Lotura-STAC/STAC-Embedded/README.md

# STAC-Embedded
Hardware PCB & Image
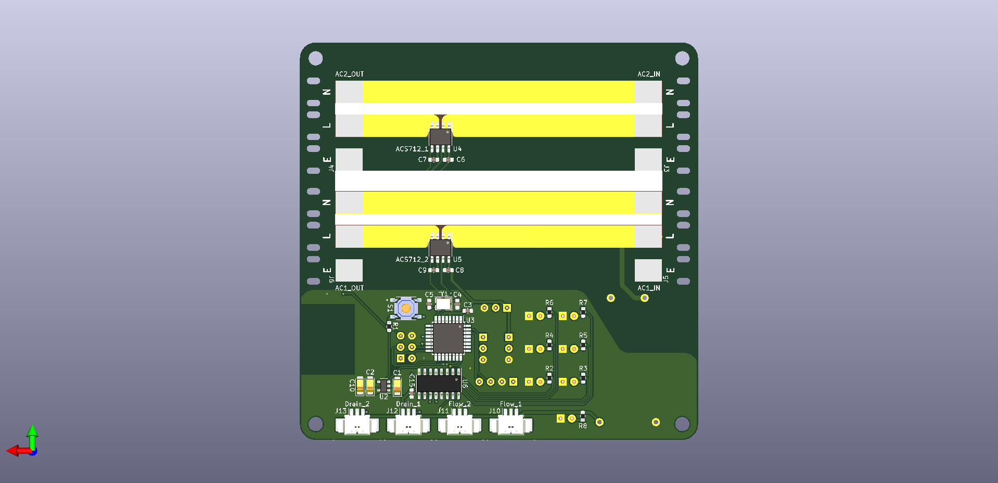
[picture p1: HardWare/Image/ac_current_v1_botom.png]
bottom

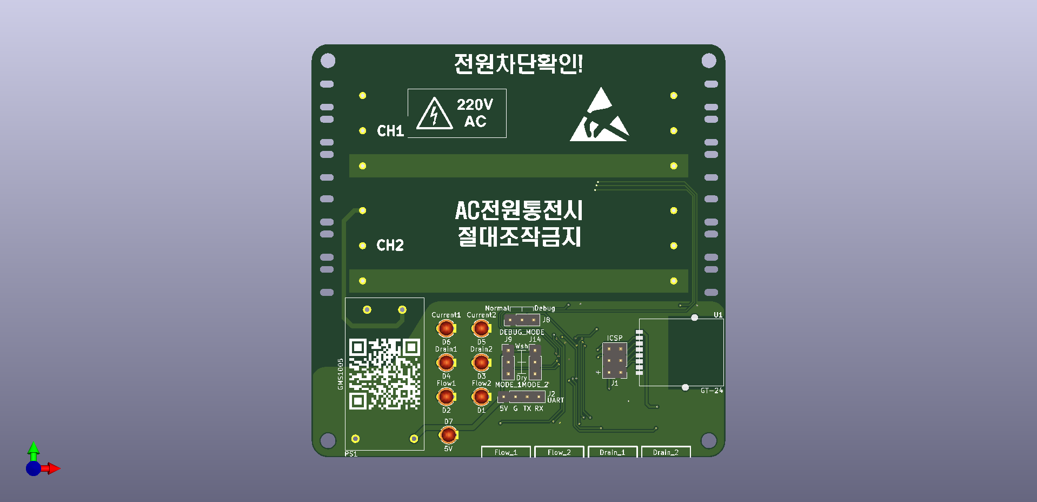
[picture p2: HardWare/Image/ac_current_v1_top.png]
top
