Lotura-STAC/STAC-Embedded/HardWare/Image/KakaoTalk_20230524_181618961.jpg

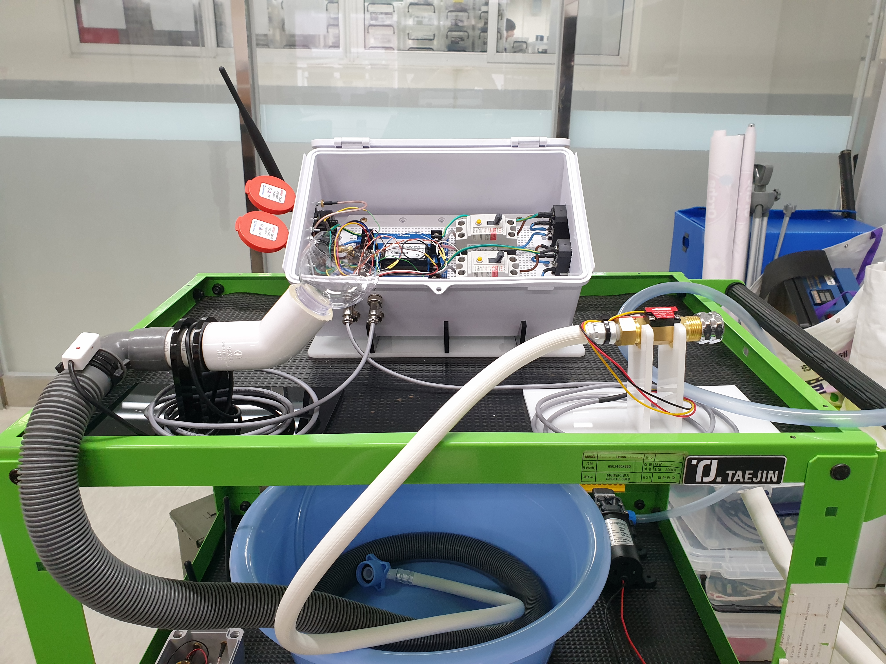
HardWare/Image/KakaoTalk_20230524_181618961.jpg
