Lotura-STAC/STAC-Embedded/HardWare/PCB/ac_current_v1.kicad_pcb

## KiCad design HardWare/PCB/ac_current_v1.kicad_pcb (2023-09-21)

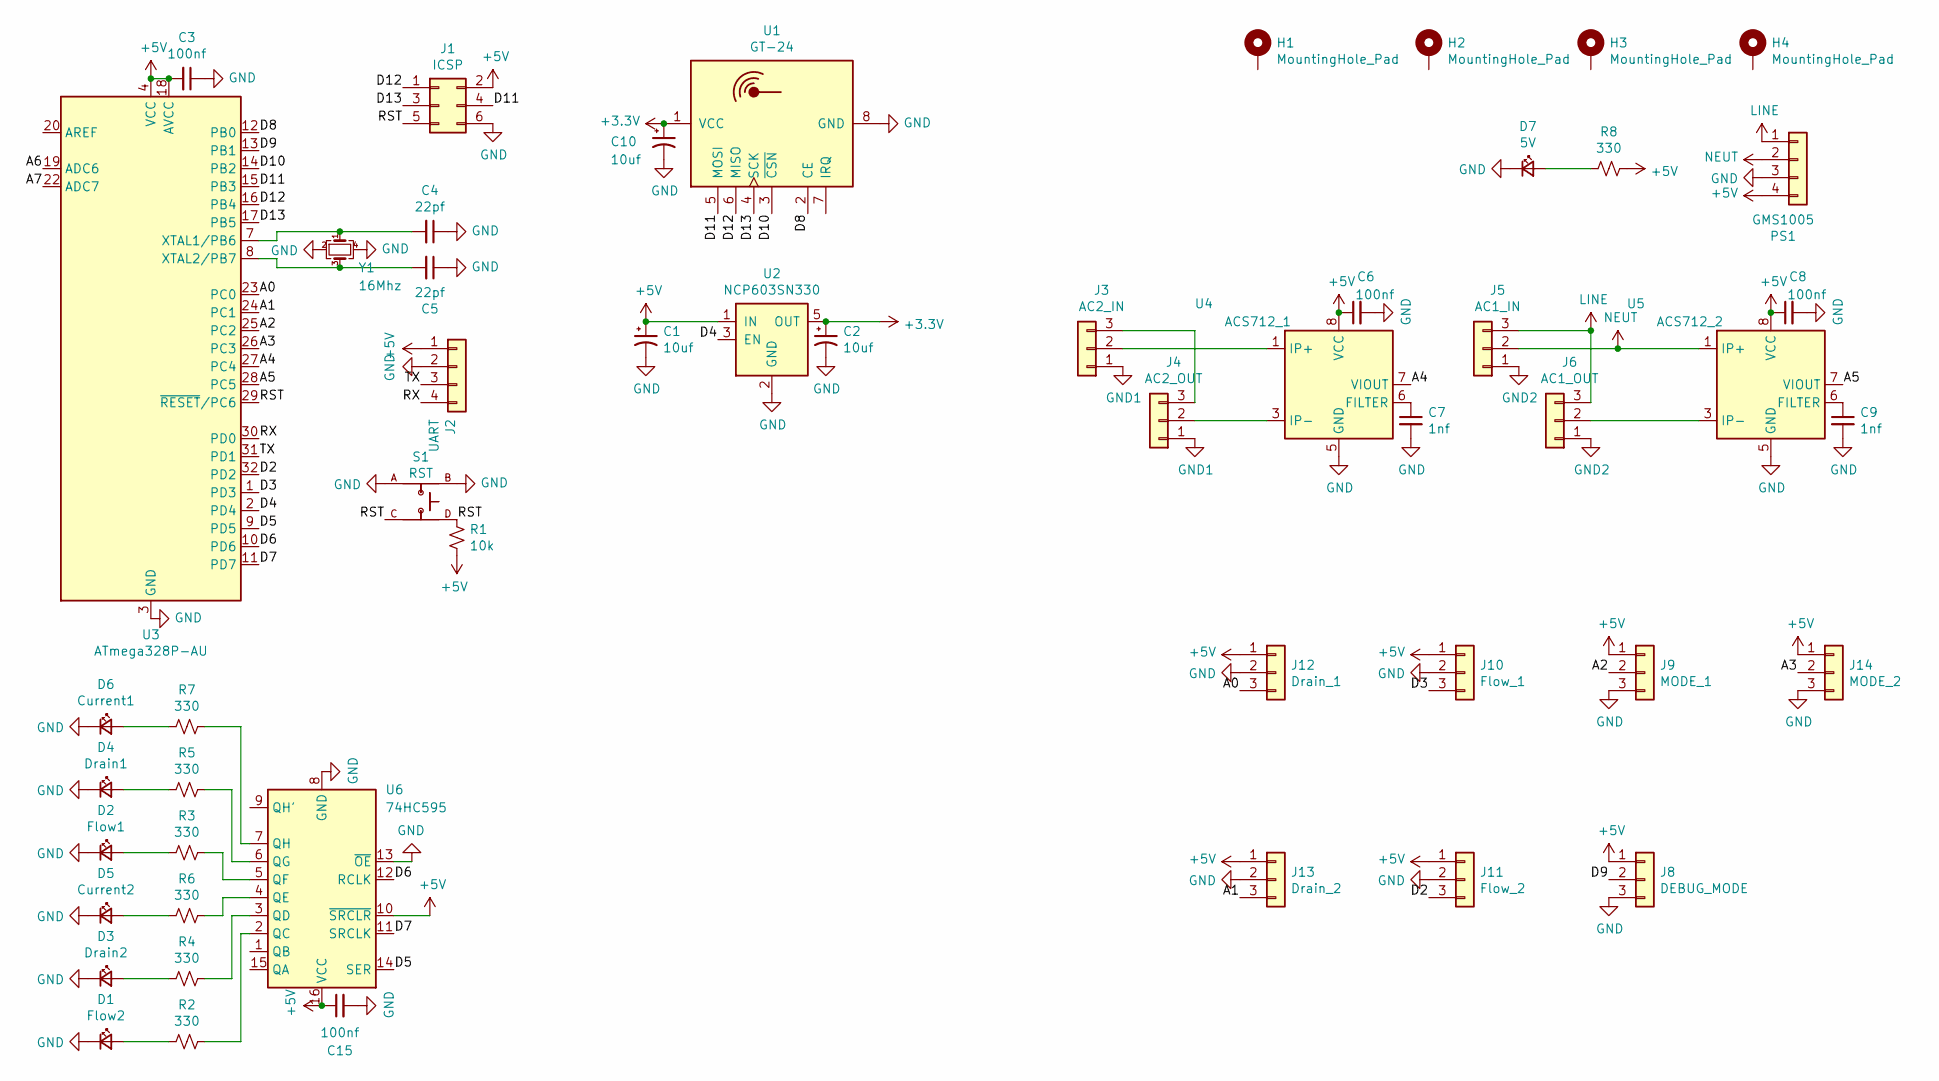
[picture p4: schematic ac_current_v1.sch, Ac Current meter]

Parts:
C1, C2, C10: 10uf; CP_EIA-3216-18_Kemet-A
C3, C6, C8, C15: 100nf; C_0603_1608Metric
C4, C5: 22pf; C_0603_1608Metric
C7, C9: 1nf; C_0603_1608Metric
D1: Flow2; LED_D3.0mm
D2: Flow1; LED_D3.0mm
D3: Drain2; LED_D3.0mm
D4: Drain1; LED_D3.0mm
D5: Current2; LED_D3.0mm
D6: Current1; LED_D3.0mm
D7: 5V; LED_D3.0mm
H1, H2, H3, H4: MountingHole_Pad; MountingHole_3.2mm_M3
J1: ICSP; PinHeader_2x03_P2.54mm_Vertical
J2: UART; PinHeader_1x04_P2.54mm_Vertical
J3: AC2_IN; SMD_762
J4: AC2_OUT; SMD_762
J5: AC1_IN; SMD_762
J6: AC1_OUT; SMD_762
J8: DEBUG_MODE; PinHeader_1x03_P2.54mm_Vertical
J9: MODE_1; PinHeader_1x03_P2.54mm_Vertical
J10: Flow_1; Molex_PicoBlade_53261-0371_1x03-1MP_P1.25mm_Horizontal
J11: Flow_2; Molex_PicoBlade_53261-0371_1x03-1MP_P1.25mm_Horizontal
J12: Drain_1; Molex_PicoBlade_53261-0371_1x03-1MP_P1.25mm_Horizontal
J13: Drain_2; Molex_PicoBlade_53261-0371_1x03-1MP_P1.25mm_Horizontal
J14: MODE_2; PinHeader_1x03_P2.54mm_Vertical
PS1: GMS1005; GMS0505
R1: 10k; R_0603_1608Metric
R2, R3, R4, R5, R6, R7, R8: 330; R_0603_1608Metric
S1: RST; SW_TS-1187A-B-A-B; PARTREV A0
U1: GT-24; nrf24l01 smd
U2: NCP603SN330; TSOP-5_1.65x3.05mm_P0.95mm
U3: ATmega328P-AU; TQFP-32_7x7mm_P0.8mm
U4: ACS712_1; SOIC-8_3.9x4.9mm_P1.27mm
U5: ACS712_2; SOIC-8_3.9x4.9mm_P1.27mm
U6: 74HC595; SO-16_3.9x9.9mm_P1.27mm
Y1: 16Mhz; Crystal_SMD_3225-4Pin_3.2x2.5mm

Connections:
+3V3: C2.1, C10.1, U1.1 (VCC), U2.5 (OUT)
+5V: C1.1, C3.2, C6.1, C8.1, C15.1, J1.2, J2.1, J8.1, J9.1, J10.1, J11.1, J12.1, J13.1, J14.1, PS1.4, R1.2, R8.1, U2.1 (IN), U3.4 (VCC), U3.6 (VCC), U3.18 (AVCC), U4.8 (VCC), U5.8 (VCC), U6.10 (~SRCLR), U6.16 (VCC)
/A0: J12.3, U3.23 (PC0)
/A1: J13.3, U3.24 (PC1)
/A2: J9.2, U3.25 (PC2)
/A3: J14.2, U3.26 (PC3)
/A4: U3.27 (PC4), U4.7 (VIOUT)
/A5: U3.28 (PC5), U5.7 (VIOUT)
/A6: U3.19 (ADC6)
/A7: U3.22 (ADC7)
/D2: J11.3, U3.32 (PD2)
/D3: J10.3, U3.1 (PD3)
/D4: U2.3 (EN), U3.2 (PD4)
/D5: U3.9 (PD5), U6.14 (SER)
/D6: U3.10 (PD6), U6.12 (RCLK)
/D7: U3.11 (PD7), U6.11 (SRCLK)
/D8: U1.2 (CE), U3.12 (PB0)
/D9: J8.2, U3.13 (PB1)
/D10: U1.3 (~CSN), U3.14 (PB2)
/D11: J1.4, U1.5 (MOSI), U3.15 (PB3)
/D12: J1.1, U1.6 (MISO), U3.16 (PB4)
/D13: J1.3, U1.4 (SCK), U3.17 (PB5)
/RST: J1.5, R1.1, S1.C, S1.D, U3.29 (~RESET~/PC6)
/RX: J2.4, U3.30 (PD0)
/TX: J2.3, U3.31 (PD1)
GND: C1.2, C2.2, C3.1, C4.1, C5.1, C6.2, C7.2, C8.2, C9.2, C10.2, C15.2, D1.1 (K), D2.1 (K), D3.1 (K), D4.1 (K), D5.1 (K), D6.1 (K), D7.1 (K), J1.6, J2.2, J8.3, J9.3, J10.2, J11.2, J12.2, J13.2, J14.3, PS1.3, S1.A, S1.B, U1.8 (GND), U2.2 (GND), U3.3 (GND), U3.5 (GND), U3.21 (GND), U4.5 (GND), U5.5 (GND), U6.8 (GND), U6.13 (~OE), Y1.2, Y1.4
GND1: J3.1, J4.1
GND2: J5.1, J6.1
LINE: J5.3, J6.3, PS1.1
NEUT: J5.2, PS1.2, U5.1 (IP+), U5.2 (IP+)
unnamed: C4.2, U3.7 (XTAL1/PB6), Y1.1
unnamed: C5.2, U3.8 (XTAL2/PB7), Y1.3
unnamed: C7.1, U4.6 (FILTER)
unnamed: C9.1, U5.6 (FILTER)
unnamed: D1.2 (A), R2.2
unnamed: D2.2 (A), R3.2
unnamed: D3.2 (A), R4.2
unnamed: D4.2 (A), R5.2
unnamed: D5.2 (A), R6.2
unnamed: D6.2 (A), R7.2
unnamed: D7.2 (A), R8.2
unnamed: J3.2, U4.1 (IP+), U4.2 (IP+)
unnamed: J3.3, J4.3
unnamed: J4.2, U4.3 (IP-), U4.4 (IP-)
unnamed: J6.2, U5.3 (IP-), U5.4 (IP-)
unnamed: R2.1, U6.2 (QC)
unnamed: R3.1, U6.5 (QF)
unnamed: R4.1, U6.3 (QD)
unnamed: R5.1, U6.6 (QG)
unnamed: R6.1, U6.4 (QE)
unnamed: R7.1, U6.7 (QH)

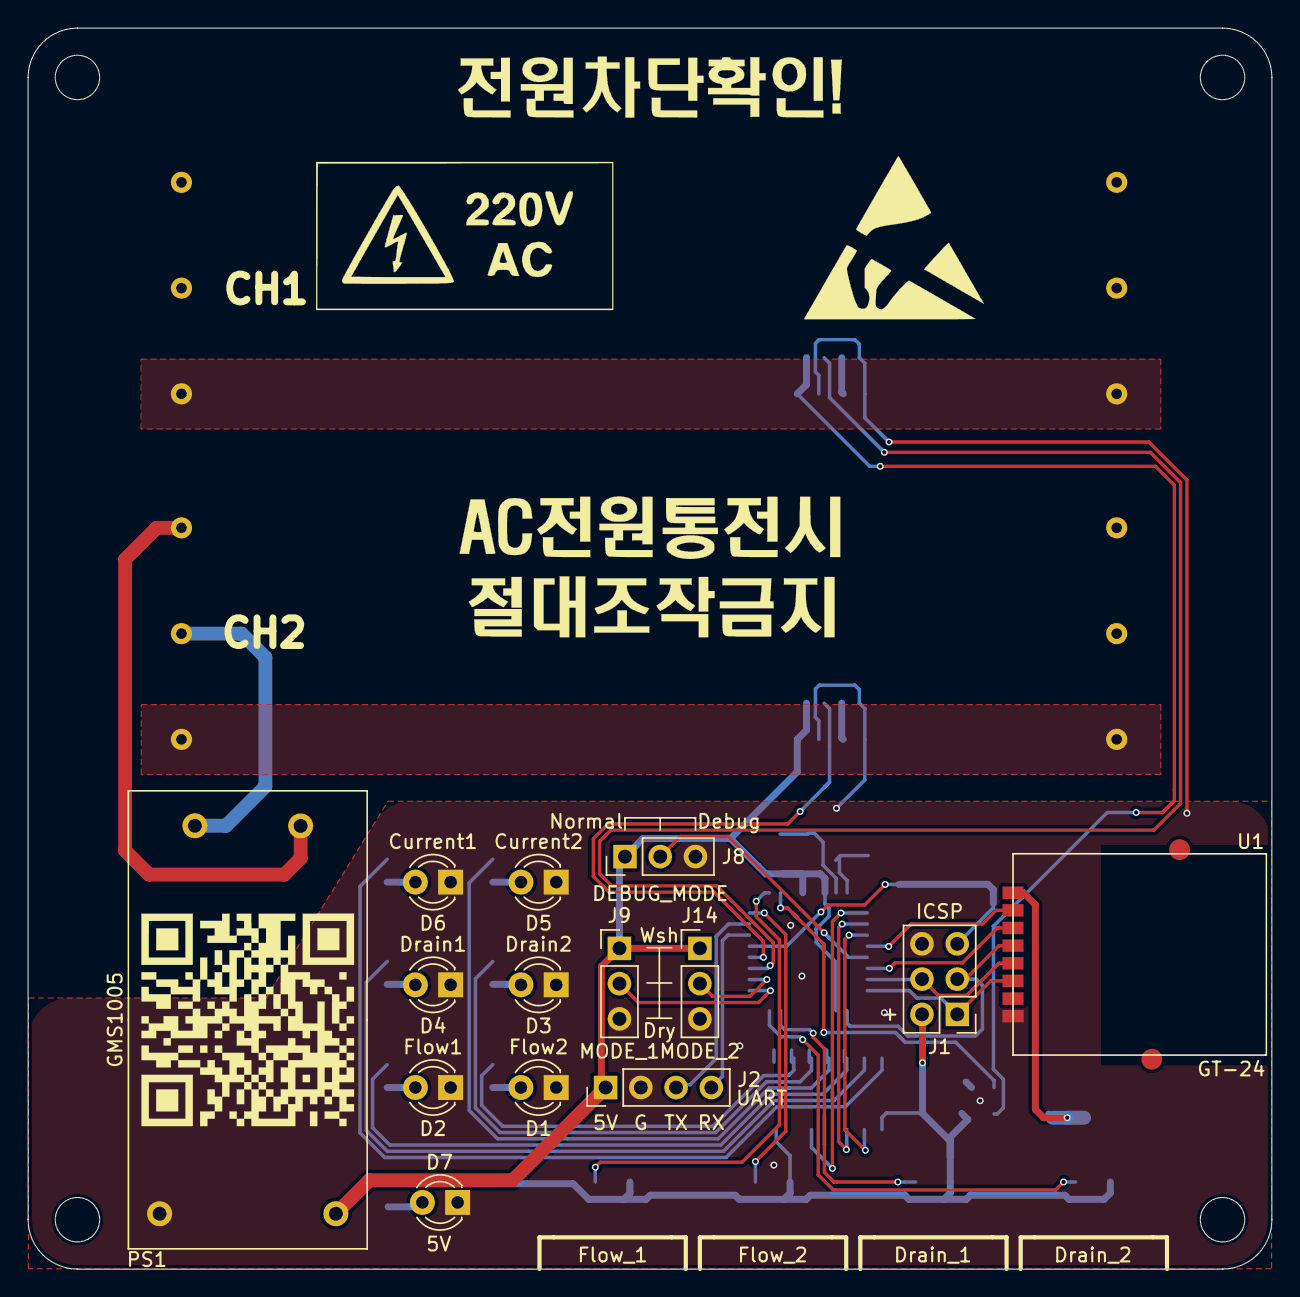
[picture p5: board ac_current_v1.kicad_pcb from above]

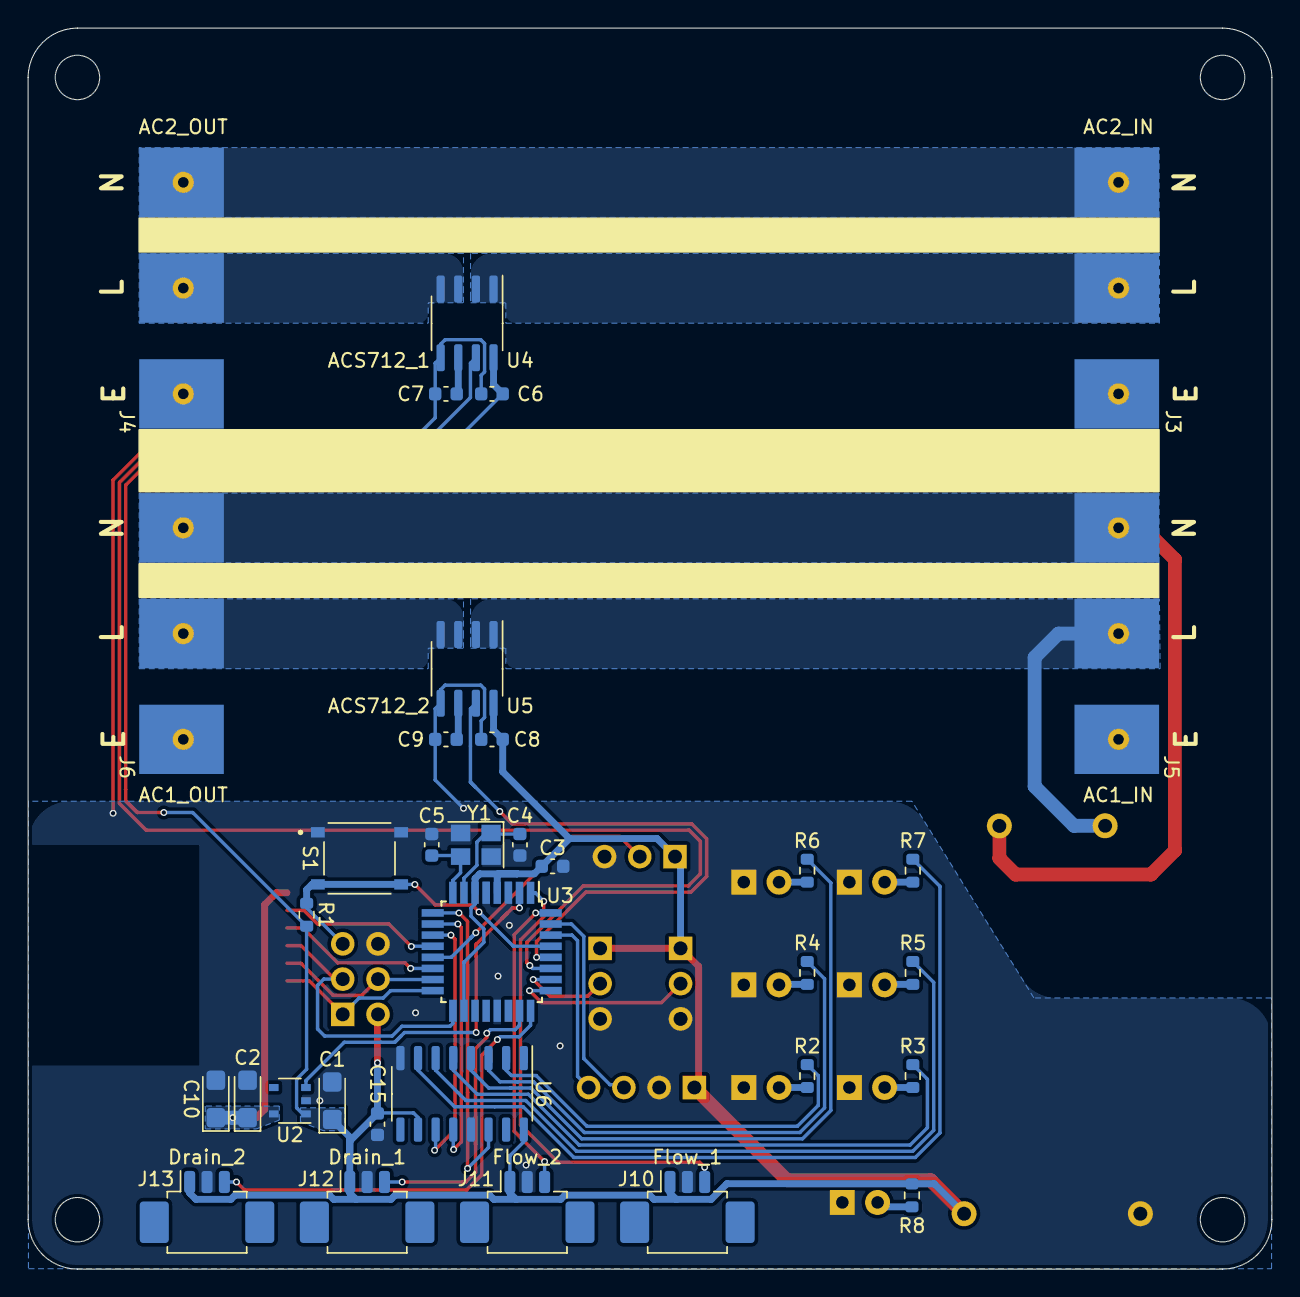
[picture p6: board ac_current_v1.kicad_pcb from below]

Board: 2 copper layers, 89.6 x 89.4 mm, 52 parts (34 on the bottom side), 49 nets.
