Lotura-STAC/STAC-Embedded/(commit log)

2023-09-14 노드 펌웨어 작성, 게이트웨이 펌웨어 작성
2023-09-14 HW폴더 생성
2023-09-15 Gateway 코드 수정
2023-09-15 json 헤더 수정
2023-09-15 통신에러 수정
2023-09-18 Gateway SSL 적용
2023-09-18 HTTPS 포트 수정
2023-09-21 PCB 파일 추가, 이미지 추가
    [ac_current_v1.csv, ac_current_v1.kicad_pcb, ac_current_v1.sch]
2023-09-21 주석 추가 및 함수 추가
